Zoestra/Roto-Pad/Handwired/STL/Indicator.stl

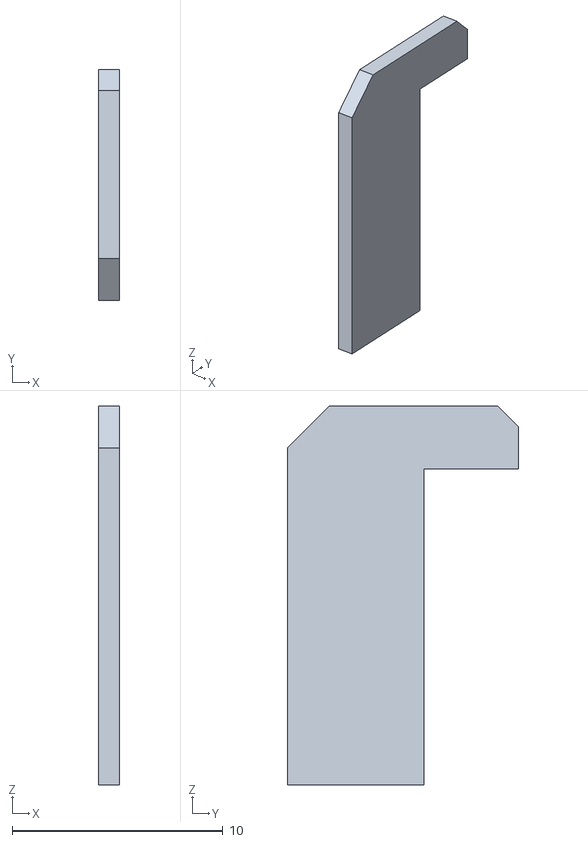
[picture p1: CAD file, 2022-07-13]
Handwired/STL/Indicator.stl
1.00 x 11.0 x 18.0
