Zoestra/Roto-Pad/Handwired/STL/Keycaps/keycap_9.stl

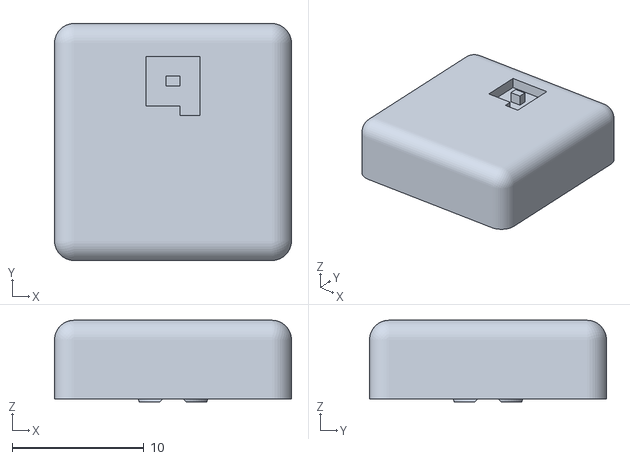
[picture p2: CAD file, 2022-07-13]
Handwired/STL/Keycaps/keycap_9.stl
18.0 x 18.0 x 6.20
