Zoestra/Roto-Pad/Handwired/STL/Keycaps/1.5 enter key_stemv2.stl

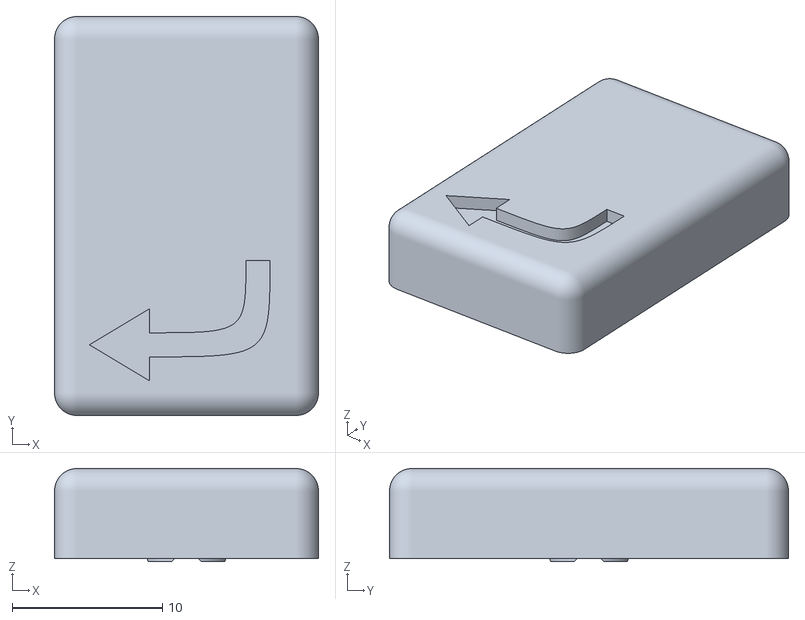
[picture p3: CAD file, 2022-07-13]
Handwired/STL/Keycaps/1.5 enter key_stemv2.stl
17.6 x 26.6 x 6.20
