Zoestra/Roto-Pad/Handwired/STL/plate.stl

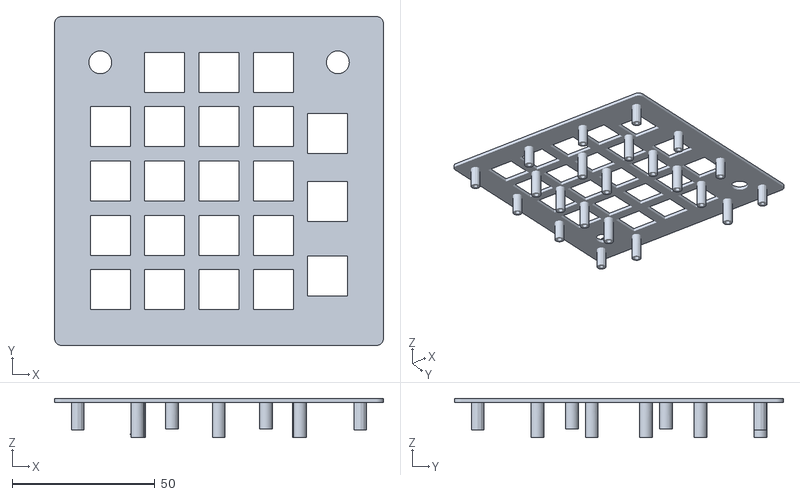
[picture p4: CAD file, 2022-07-13]
Handwired/STL/plate.stl
115.4 x 115.4 x 13.8
