Zoestra/Roto-Pad/Handwired/STL/knob.stl

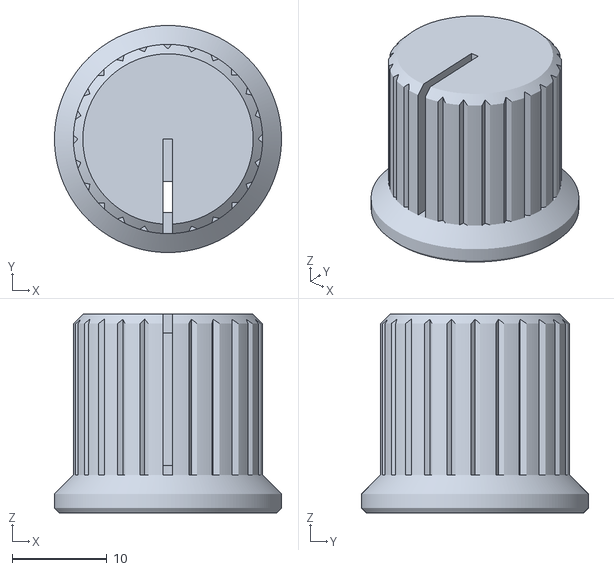
[picture p5: CAD file, 2022-07-13]
Handwired/STL/knob.stl
24.0 x 24.0 x 21.0
