Zoestra/Roto-Pad/Handwired/STL/backplate.stl

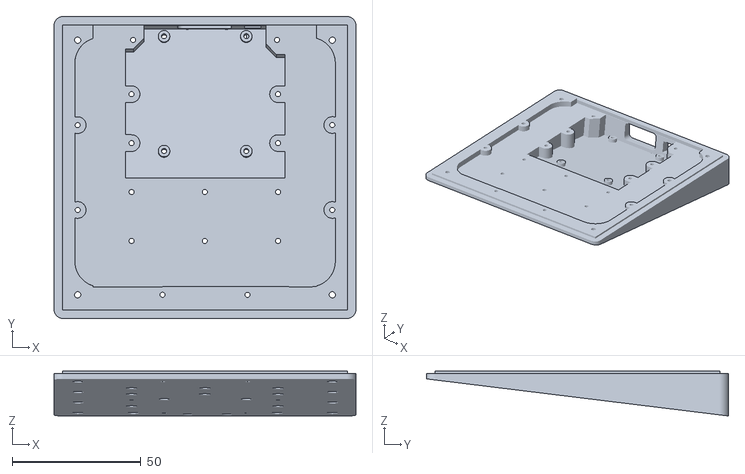
[picture p6: CAD file, 2022-07-13]
Handwired/STL/backplate.stl
117.5 x 117.5 x 17.5
