Zoestra/Roto-Pad/Handwired/STL/mcu.stl

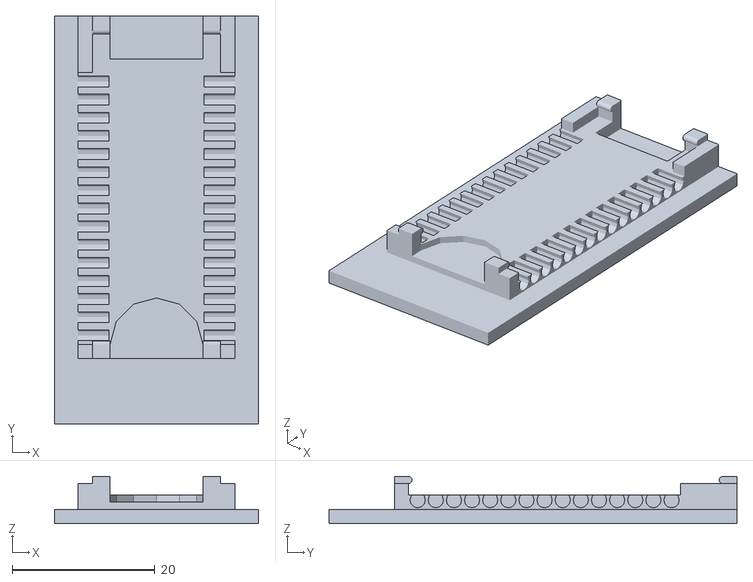
[picture p7: CAD file, 2022-07-13]
Handwired/STL/mcu.stl
28.6 x 57.2 x 6.60
