Zoestra/Roto-Pad/Handwired/STL/Keycaps/keycap_plus_V2.stl

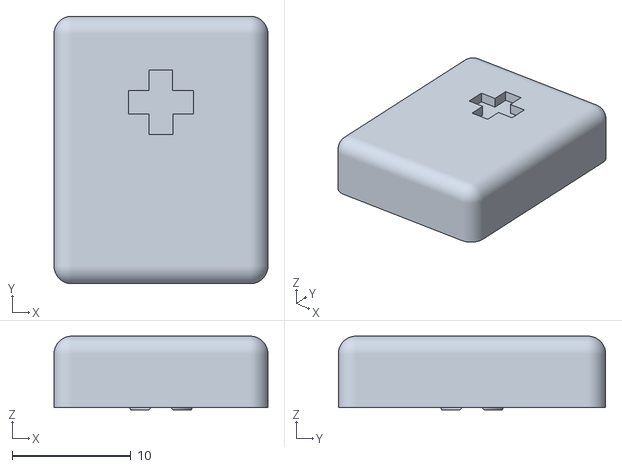
[picture p8: CAD file, 2022-07-13]
Handwired/STL/Keycaps/keycap_plus_V2.stl
18.0 x 22.5 x 6.20
