Zoestra/Roto-Pad/(list of files, cad)

Other CAD files:
Handwired/STL/Keycaps/keycap_7.stl
Handwired/STL/Keycaps/keycap_radv2.stl
Handwired/STL/Keycaps/keycap_8.stl
Handwired/STL/Keycaps/keycap_slash_v2.stl
Handwired/STL/Keycaps/keycap_radv3.stl
Handwired/STL/Keycaps/keycap_5.stl
Handwired/STL/Keycaps/keycap_blank.stl
Handwired/STL/Keycaps/keycap_6.stl
Handwired/STL/Keycaps/keycap_4.stl
Handwired/STL/Keycaps/keycap_star_v2.stl
Handwired/STL/Keycaps/keycap_1.stl
Handwired/STL/Keycaps/keycap_brackets_V2.stl
Handwired/STL/Keycaps/keycap_Backspace_v2.stl
Handwired/STL/Keycaps/keycap_x_y_v2.stl
Handwired/STL/Keycaps/keycap_per_com_v2.stl
Handwired/STL/Keycaps/keycap_sickle.stl
Handwired/STL/Keycaps/keycap_0.stl
Handwired/STL/Keycaps/keycap_2.stl
Handwired/STL/Keycaps/keycap_3_pi_v3.stl
Handwired/STL/Keycaps/keycap_minus_V2.stl
Handwired/SCAD/keyboard.scad
Handwired/SCAD/backplate.scad
Handwired/SCAD/case.scad
Handwired/SCAD/default_layout.scad
Handwired/SCAD/diode_bending_template.scad
Handwired/SCAD/grid_patterns.scad
Handwired/SCAD/pcb.scad
Handwired/SCAD/plate.scad
Handwired/SCAD/stabilizer.scad
Handwired/SCAD/stabilizer_spacing.scad
Handwired/SCAD/standoff.scad
Handwired/SCAD/switch.scad
Handwired/SCAD/trrs.scad
Handwired/SCAD/utils.scad
Handwired/SCAD/via.scad
Handwired/STL/Keycaps/keycap_3_pi_v2.stl
