Zoestra/Roto-Pad/PCB/Roto-Pad_ProMicro/Roto-Pad.kicad_pcb

## KiCad design PCB/Roto-Pad_ProMicro/Roto-Pad.kicad_pcb (2022-07-13)

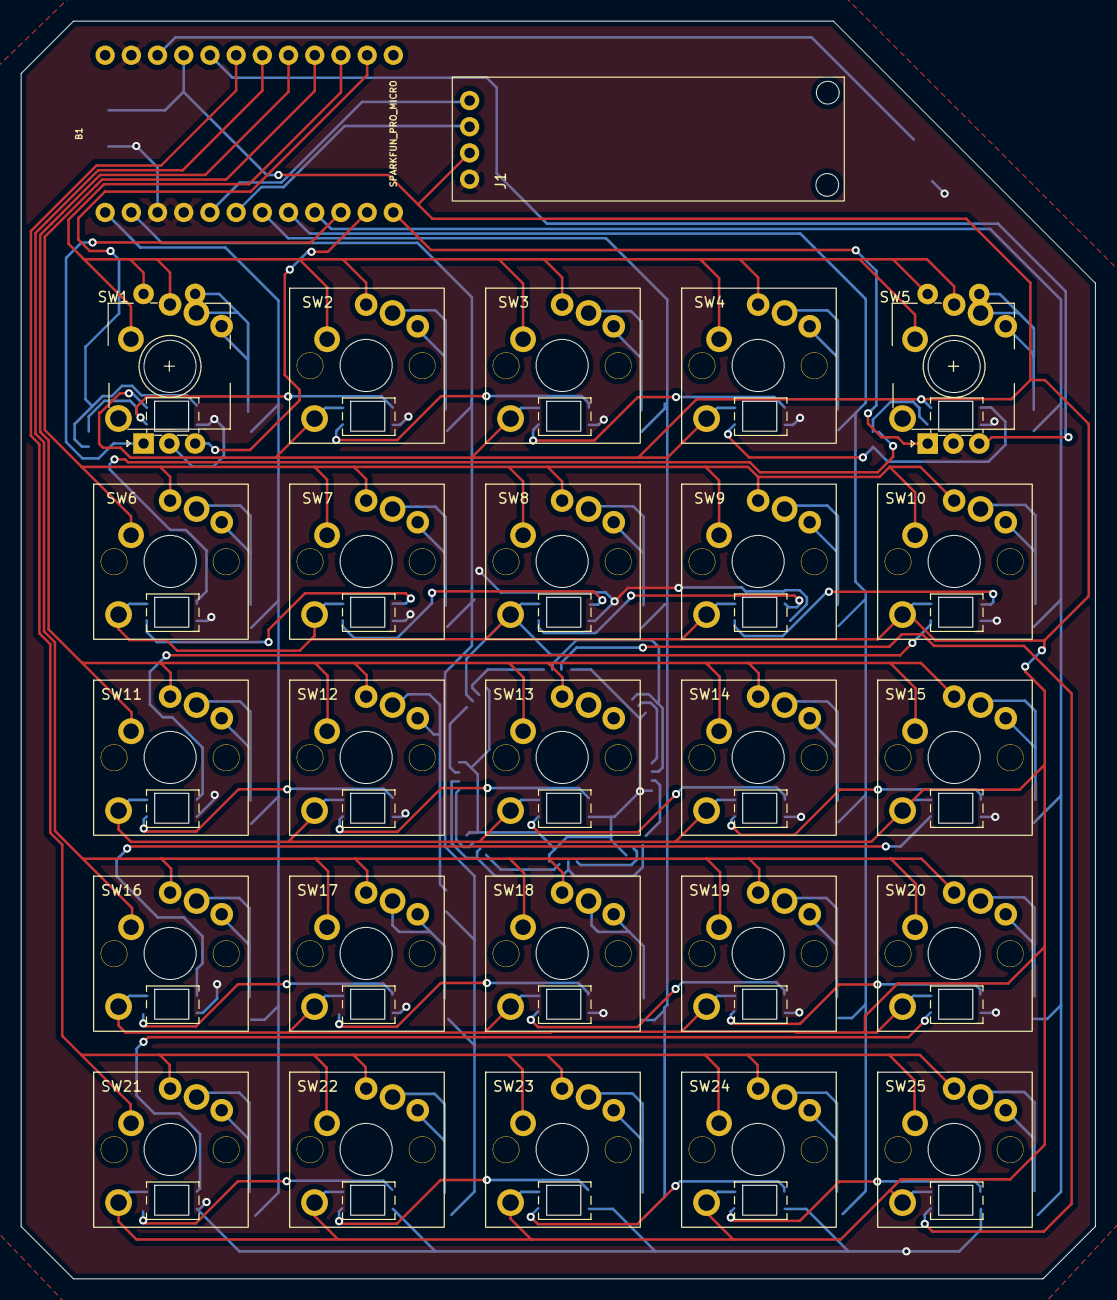
[picture p9: board Roto-Pad.kicad_pcb from above]

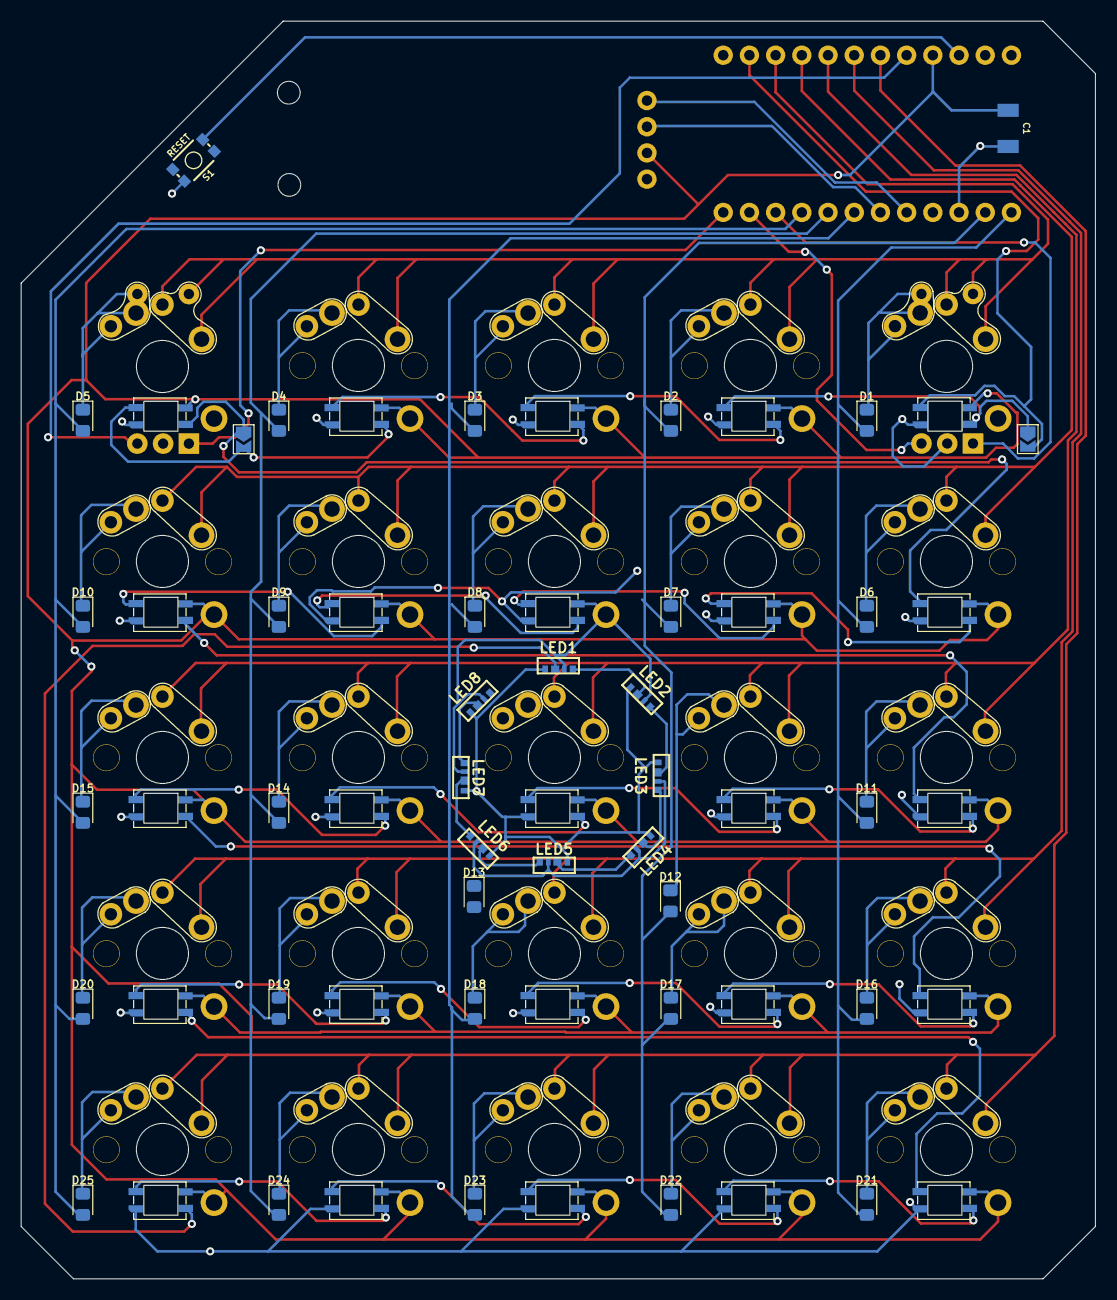
[picture p10: board Roto-Pad.kicad_pcb from below]

Board: 2 copper layers, 104.1 x 121.9 mm, 62 parts (35 on the bottom side), 77 nets.

Parts:
B1: SPARKFUN_PRO_MICRO
C1: C_Polarized_1000uf; 1210
D1, D2, D3, D4, D5, D6, D7, D8, D9, D10, D11, D12, D13, D14, D15, D16, D17, D18, D19, D20, D21, D22, D23, D24, D25: DIODE-1N4148; D_0805_2012Metric_Pad1.15x1.40mm_HandSolder
J1: I2C_STANDARD_NO_SILK; TINY OLED I2C
LED1, LED2, LED3, LED4, LED5, LED6, LED7, LED8: LED_SK6812; WS2812B-4020
S1: RESET; TACTILE_SWITCH_SMD_4.6X2.8MM
SW1, SW5: RotarySwitchLedHybrid; xX_Super_Heckin_Valid_Rotary_MX_Kailh_Hybrid_UwU_Xx
SW2, SW3, SW4, SW6, SW7, SW8, SW9, SW10, SW11, SW12, SW13, SW14, SW15, SW16, SW17, SW18, SW19, SW20, SW21, SW22, SW23, SW24, SW25: HECKIN_LED_SWITCH; xX_Super_Heckin_Valid_MX_CHOC_SK6812MINIE_ONESIDE_KEYSWITCH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

Connections:
5V: B1.21 (VCC), C1.1, J1.VCC, LED1.3 (VDD), LED2.3 (VDD), LED3.3 (VDD), LED4.3 (VDD), LED5.3 (VDD), LED6.3 (VDD), LED7.3 (VDD), LED8.3 (VDD), SW1.3 (5v), SW2.3 (5v), SW3.3 (5v), SW4.3 (5v), SW5.3 (5v), SW6.3 (5v), SW7.3 (5v), SW8.3 (5v), SW9.3 (5v), SW10.3 (5v), SW11.3 (5v), SW12.3 (5v), SW13.3 (5v), SW14.3 (5v), SW15.3 (5v), SW16.3 (5v), SW17.3 (5v), SW18.3 (5v), SW19.3 (5v), SW20.3 (5v), SW21.3 (5v), SW22.3 (5v), SW23.3 (5v), SW24.3 (5v), SW25.3 (5v)
Col1: B1.2 (RXI), D2.C, D7.C, D12.C, D17.C, D22.C
Col 0: B1.1 (TXO), D1.C, D6.C, D11.C, D16.C, D21.C
Col 2: B1.7 (4), D3.C, D8.C, D13.C, D18.C, D23.C
Col 3: B1.8 (*5), D4.C, D9.C, D14.C, D19.C, D24.C
Col 4: B1.9 (*6), D5.C, D10.C, D15.C, D20.C, D25.C
Earth: B1.3 (GND), B1.4 (GND), B1.23 (GND), C1.2, J1.GND, LED1.1 (VSS), LED2.1 (VSS), LED3.1 (VSS), LED4.1 (VSS), LED5.1 (VSS), LED6.1 (VSS), LED7.1 (VSS), LED8.1 (VSS), S1.3, SW1.6 (GND), SW1.C, SW2.6 (GND), SW3.6 (GND), SW4.6 (GND), SW5.6 (GND), SW5.C, SW6.6 (GND), SW7.6 (GND), SW8.6 (GND), SW9.6 (GND), SW10.6 (GND), SW11.6 (GND), SW12.6 (GND), SW13.6 (GND), SW14.6 (GND), SW15.6 (GND), SW16.6 (GND), SW17.6 (GND), SW18.6 (GND), SW19.6 (GND), SW20.6 (GND), SW21.6 (GND), SW22.6 (GND), SW23.6 (GND), SW24.6 (GND), SW25.6 (GND)
LED CONTROL: B1.14 (11(MOSI)), SW1.5 (DIN)
Ledthru: LED1.2 (DIN), SW25.4 (DOUT)
Ledthru2: LED4.4 (DOUT), LED5.2 (DIN)
unnamed: B1.22 (RESET), S1.1
unnamed: D1.A, SW1.2 (Sw2)
unnamed: D2.A, SW2.2 (Sw2)
unnamed: D3.A, SW3.2 (Sw2)
unnamed: D4.A, SW4.2 (Sw2)
unnamed: D5.A, SW5.2 (Sw2)
unnamed: D6.A, SW6.2 (Sw2)
unnamed: D7.A, SW7.2 (Sw2)
unnamed: D8.A, SW8.2 (Sw2)
unnamed: D9.A, SW9.2 (Sw2)
unnamed: D10.A, SW10.2 (Sw2)
unnamed: D11.A, SW11.2 (Sw2)
unnamed: D12.A, SW12.2 (Sw2)
unnamed: D13.A, SW13.2 (Sw2)
unnamed: D14.A, SW14.2 (Sw2)
unnamed: D15.A, SW15.2 (Sw2)
unnamed: D16.A, SW16.2 (Sw2)
unnamed: D17.A, SW17.2 (Sw2)
unnamed: D18.A, SW18.2 (Sw2)
unnamed: D19.A, SW19.2 (Sw2)
unnamed: D20.A, SW20.2 (Sw2)
unnamed: D21.A, SW21.2 (Sw2)
unnamed: D22.A, SW22.2 (Sw2)
unnamed: D23.A, SW23.2 (Sw2)
unnamed: D24.A, SW24.2 (Sw2)
unnamed: D25.A, SW25.2 (Sw2)
unnamed: LED1.4 (DOUT), LED2.2 (DIN)
unnamed: LED2.4 (DOUT), LED3.2 (DIN)
unnamed: LED3.4 (DOUT), LED4.2 (DIN)
unnamed: LED5.4 (DOUT), LED6.2 (DIN)
unnamed: LED6.4 (DOUT), LED7.2 (DIN)
unnamed: LED7.4 (DOUT), LED8.2 (DIN)
unnamed: SW1.4 (DOUT), SW2.5 (DIN)
unnamed: SW2.4 (DOUT), SW3.5 (DIN)
unnamed: SW3.4 (DOUT), SW4.5 (DIN)
unnamed: SW4.4 (DOUT), SW5.5 (DIN)
unnamed: SW5.4 (DOUT), SW6.5 (DIN)
unnamed: SW6.4 (DOUT), SW7.5 (DIN)
unnamed: SW7.4 (DOUT), SW8.5 (DIN)
unnamed: SW8.4 (DOUT), SW9.5 (DIN)
unnamed: SW10.4 (DOUT), SW11.5 (DIN)
unnamed: SW9.4 (DOUT), SW10.5 (DIN)
unnamed: SW11.4 (DOUT), SW12.5 (DIN)
unnamed: SW12.4 (DOUT), SW13.5 (DIN)
unnamed: SW13.4 (DOUT), SW14.5 (DIN)
unnamed: SW14.4 (DOUT), SW15.5 (DIN)
unnamed: SW15.4 (DOUT), SW16.5 (DIN)
unnamed: SW16.4 (DOUT), SW17.5 (DIN)
unnamed: SW17.4 (DOUT), SW18.5 (DIN)
unnamed: SW18.4 (DOUT), SW19.5 (DIN)
unnamed: SW19.4 (DOUT), SW20.5 (DIN)
unnamed: SW20.4 (DOUT), SW21.5 (DIN)
unnamed: SW21.4 (DOUT), SW22.5 (DIN)
unnamed: SW22.4 (DOUT), SW23.5 (DIN)
unnamed: SW23.4 (DOUT), SW24.5 (DIN)
unnamed: SW24.4 (DOUT), SW25.5 (DIN)
Rot1 A: B1.10 (7), SW1.A
Rot1B: B1.11 (8), SW1.B
Rot2B: B1.20 (A3), SW5.B
Rot 2 A: B1.12 (*9), SW5.A
Row 0: B1.15 (12(MISO)), SW1.1 (Sw1), SW2.1 (Sw1), SW3.1 (Sw1), SW4.1 (Sw1), SW5.1 (Sw1)
Row 1: B1.16 (13(SCK)), SW6.1 (Sw1), SW7.1 (Sw1), SW8.1 (Sw1), SW9.1 (Sw1), SW10.1 (Sw1)
Row 2: B1.17 (A0), SW11.1 (Sw1), SW12.1 (Sw1), SW13.1 (Sw1), SW14.1 (Sw1), SW15.1 (Sw1)
Row 3: B1.18 (A1), SW16.1 (Sw1), SW17.1 (Sw1), SW18.1 (Sw1), SW19.1 (Sw1), SW20.1 (Sw1)
Row 4: B1.19 (A2), SW21.1 (Sw1), SW22.1 (Sw1), SW23.1 (Sw1), SW24.1 (Sw1), SW25.1 (Sw1)
SCL: B1.6 (*3), J1.SCL
SDA: B1.5 (2), J1.SDA
