Zoestra/Roto-Pad/(commit log)

2022-07-13 Seeed 1st commit
    started seeed variant and reorganized folders
    [Roto-Pad.kicad_pcb, Roto-Pad.kicad_sch, Roto-Pad_SeeedXiaoBLE.kicad_pcb, Roto-Pad_SeeedXiaoBLE.kicad_sch]
2022-07-14 seeed PCB completed
    [Roto-Pad_SeeedXiaoBLE.kicad_sch]
2022-07-25 seeed board changes
    [Roto-Pad_SeeedXiaoBLE.kicad_sch]
